MooVx/Domofon/Zdi/IMAG0292.jpg

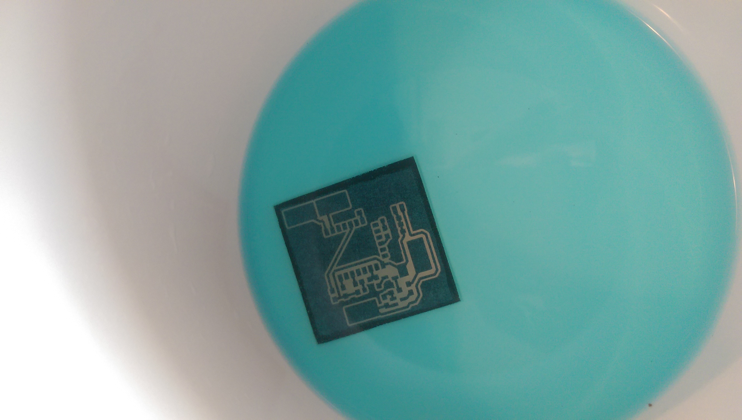
Zdi/IMAG0292.jpg
