MooVx/Domofon/Sprawozdanie.docx

Projekt – Domofon
Paweł Węgrzyn Michał Roman | 23 III 2017 | Czw. 13.30 | G5

1. Cel projektu

Postanowiliśmy wykonać w oparciu o układ ESP8266 sterowanie za pośrednictwem sieci WLAN elektrozamka domofonu. Docelowo po uzyskaniu stabilności działania, układ zamontujemy wewnątrz domofonu, po rozkręceniu aparatu znaleźliśmy wewnątrz łatwo dostępny stabilizator napięcia +12V, postanowiliśmy ze względu na stosunkowo małe zużycie energii wykorzystać to napięcie do zasalania naszego układu. Korzystając z własnego doświadczenia, schematów dostępnych w sieci oraz dokonując pomiarów dowiedzieliśmy się że wyzwolenie zaczepu elektro zamka realizowane jest przez stacje domofonową w mieszkaniu poprzez podciągniecie linii sygnałowej AUDIO do linii POWER. Podczas gdy układ nie jest zasilany stan wyjścia, docelowo zwierającego powyżej wspomniane linie rezystorem 470R, powinien znajdować się w stanie wysokiej impedancji aby nie zakłócać działania innych urządzeń podpiętych do tych linii. Cały układ postanowiliśmy zrealizować w technologii SMD w celu minimalizacji rozmiarów układu.

Podzieliliśmy realizacje projektu na następujące etapy:

a) Zaprojektowanie schematu ideowego układu
b) Zaprojektowanie PCB
c) Wykonanie płytki PCB oraz montaż elementów
d) Testy, poprawa stabilności software’u
2. Schemat ideowy

Sekcja zasilania:

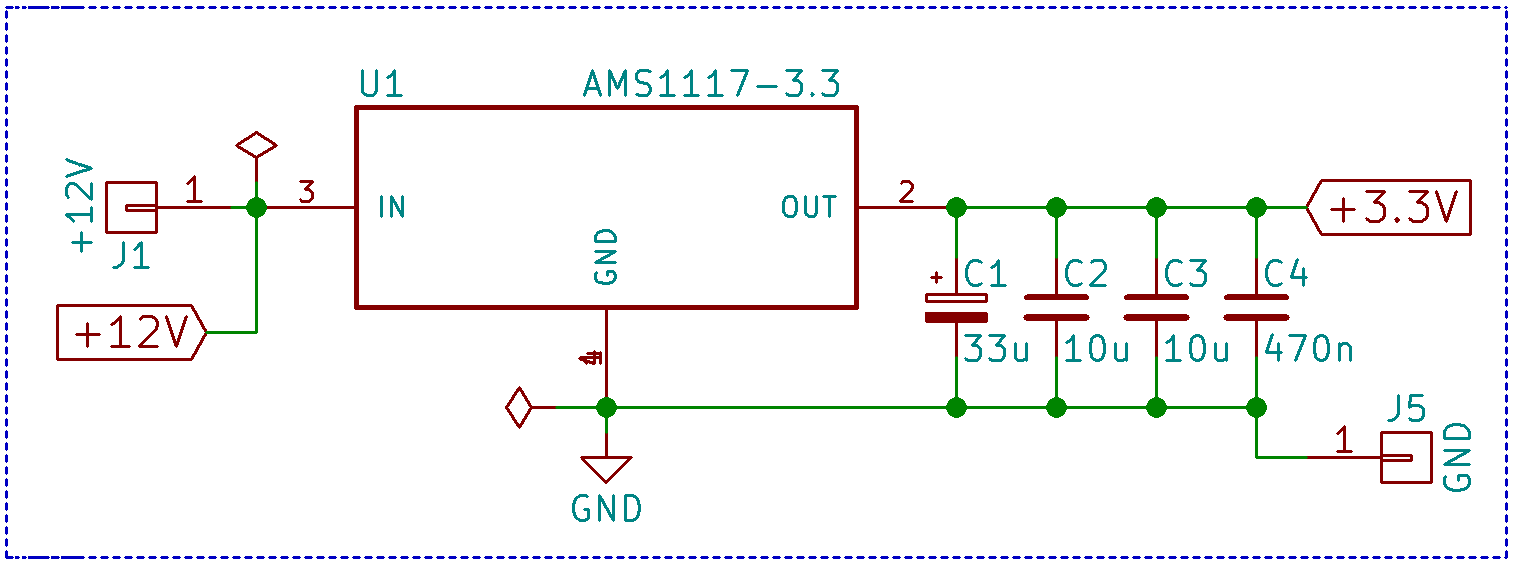
[picture p2: figure]

Zasilanie układu zrealizowane jest na regulatorze napięciowym AMS1117-3.3 który zmniejsza napięcie +12V na napięcie +3.3V. W celu eliminacji szpilek napięciowych zastosowaliśmy filtracje napięcia. Kondensator C1 jest kondensatorem tantalowym, charakteryzują się one małym współczynnikiem ESR, wiec nadaje się do eliminacji szpilek.
Sekcja logiki:

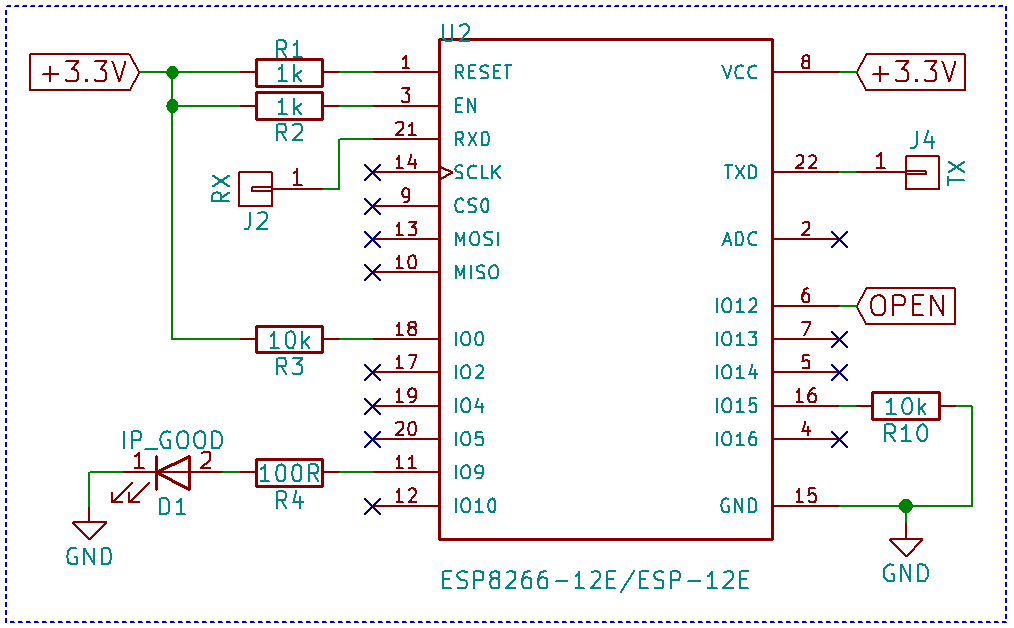
[picture p3: figure]

LED „ IP_GOOD ” podpięty jest do jednego z pinów GPIO, docelowo ma służyć do sygnalizacji prawidłowego otrzymania przydziału adresu IP.

Sekcja sterująca zamkiem:

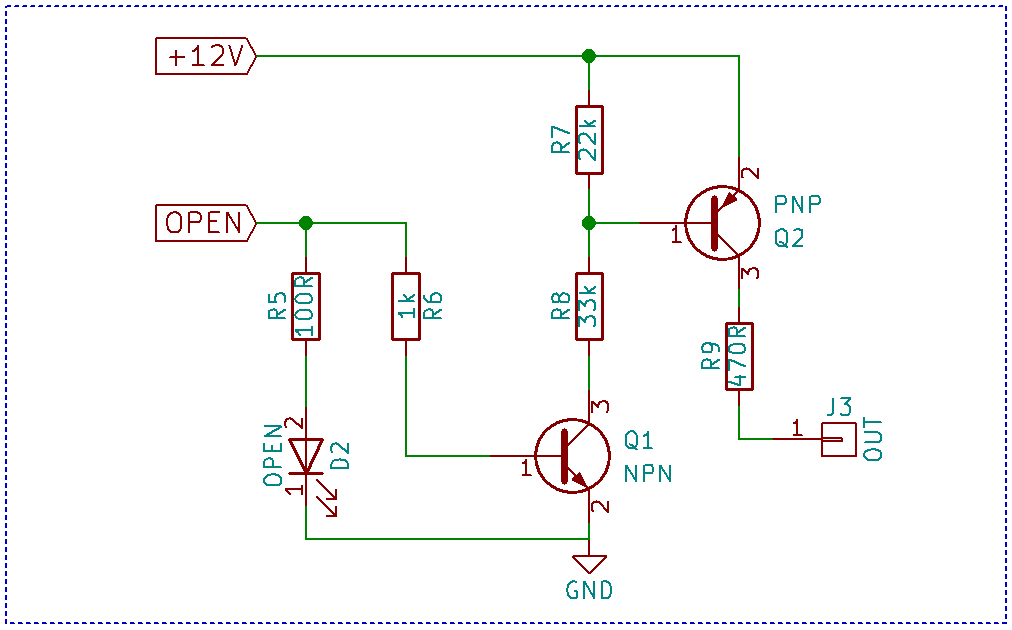
[picture p4: figure]

TODO: policzyć to pasuje xDD

3. Schemat PCB

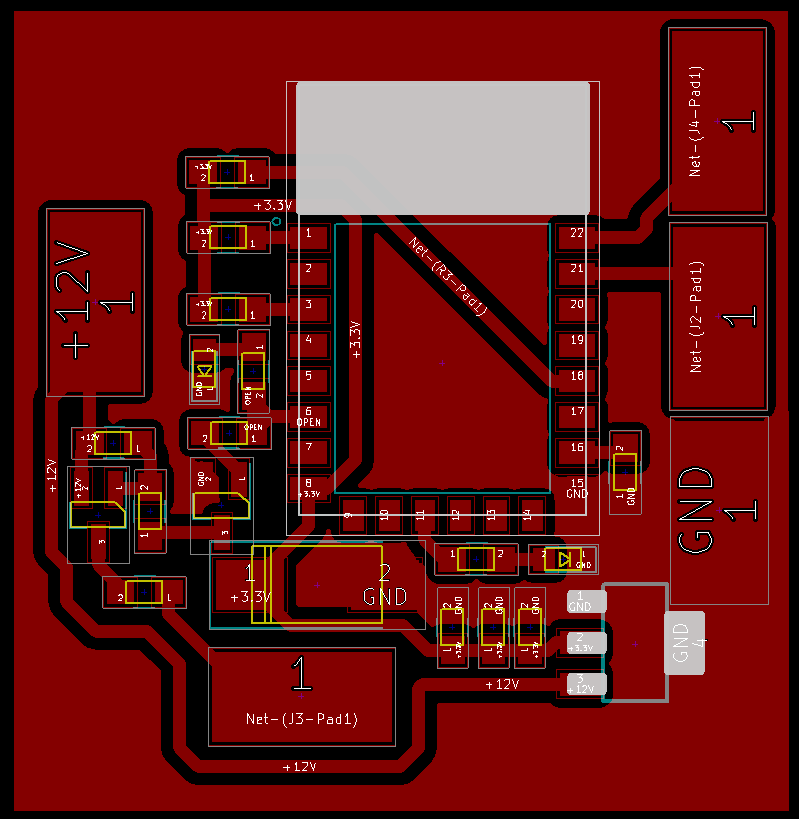
[picture p5: figure]

4. Wykonanie układu

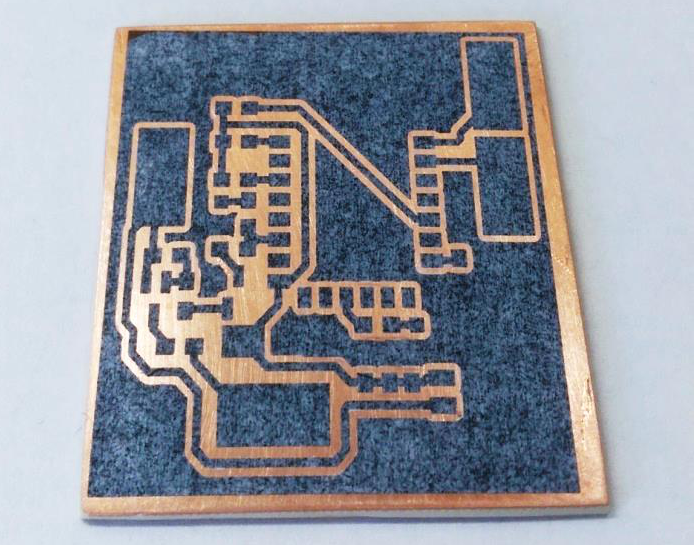
[picture p6: figure]
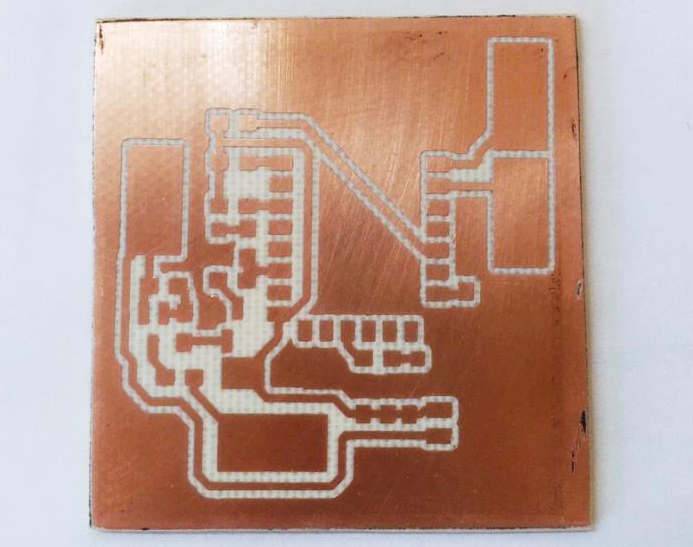
[picture p7: figure]
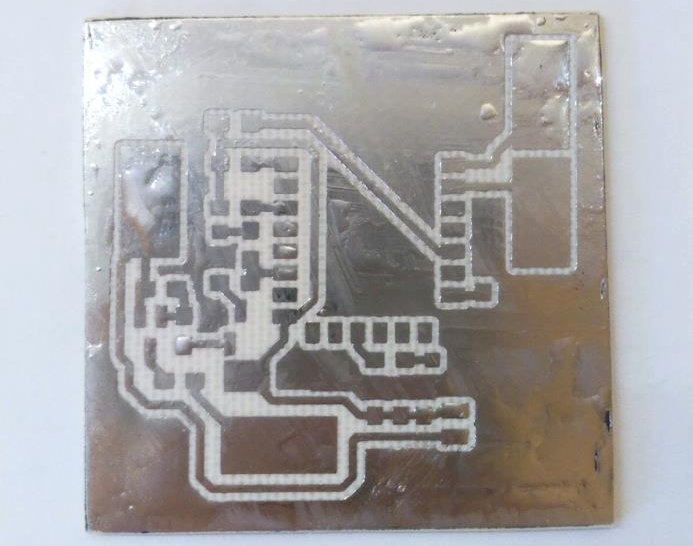
[picture p8: figure]
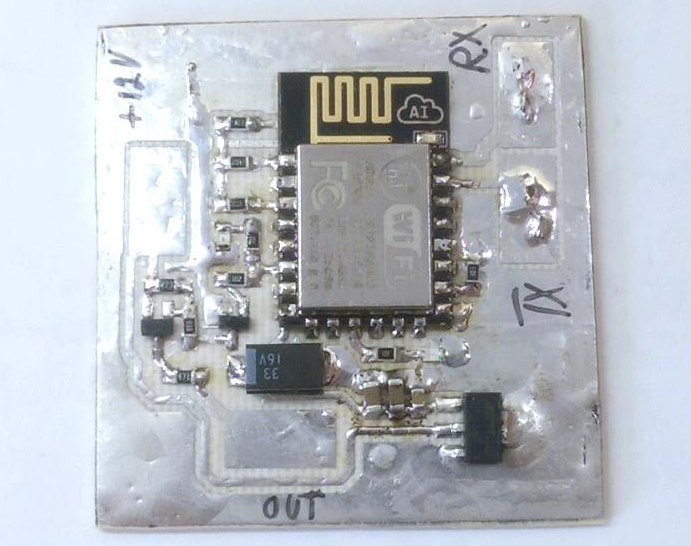
[picture p9: figure]
