MooVx/Domofon/Zdi/IMAG0290.jpg

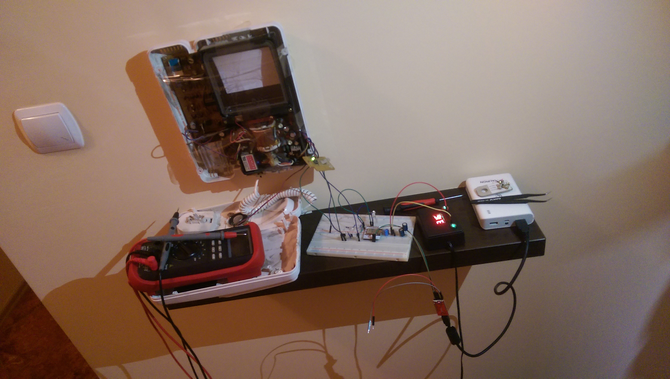
Zdi/IMAG0290.jpg
