MooVx/Domofon/Zdi/IMAG0291.jpg

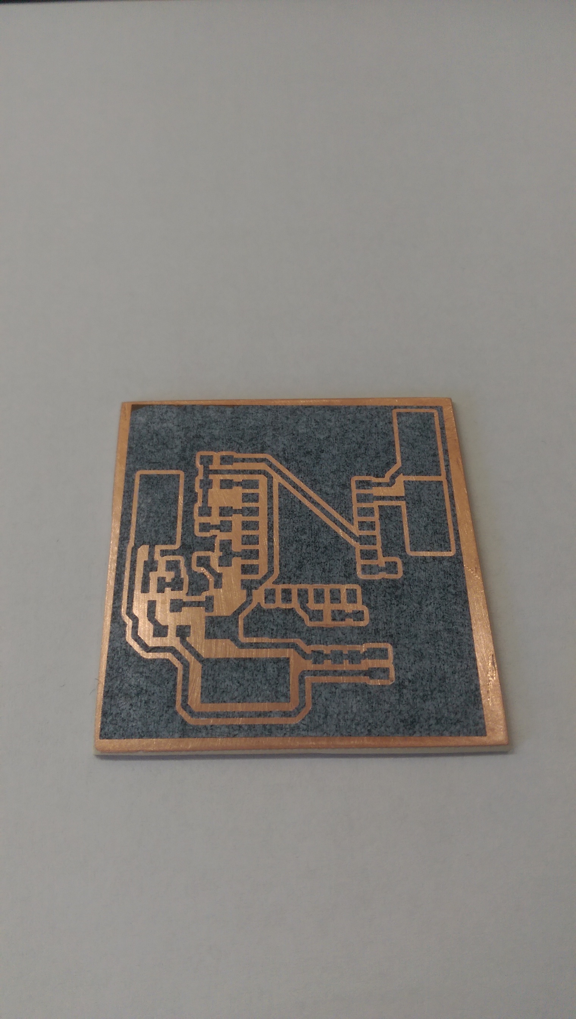
Zdi/IMAG0291.jpg
