MooVx/Domofon/Zdi/IMAG0294.jpg

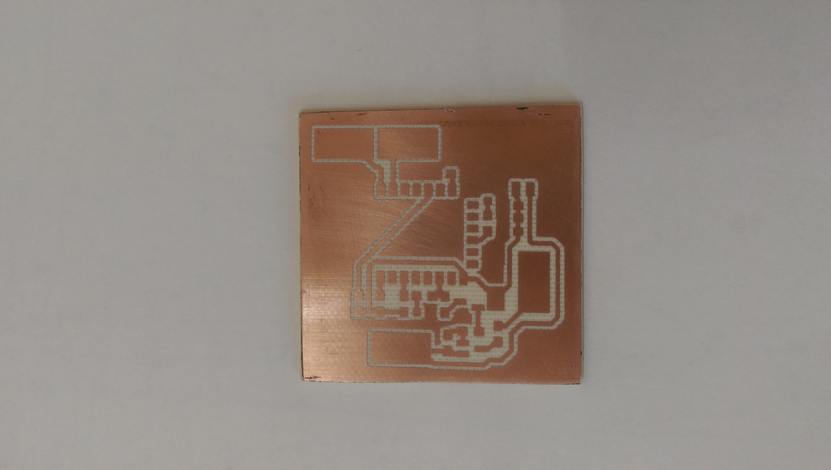
Zdi/IMAG0294.jpg
