MooVx/Domofon/Zdi/IMAG0295.jpg

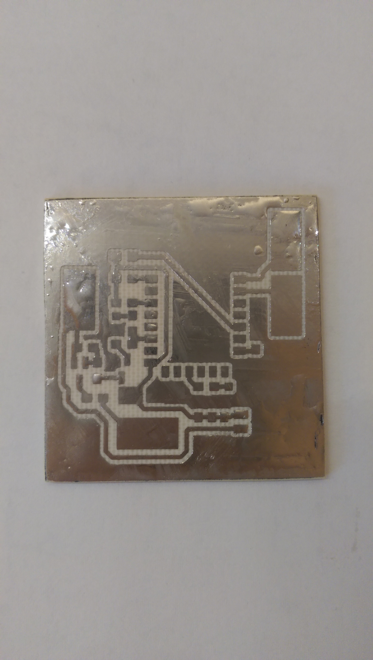
Zdi/IMAG0295.jpg
