MooVx/Domofon/Zdi/IMAG0296.jpg

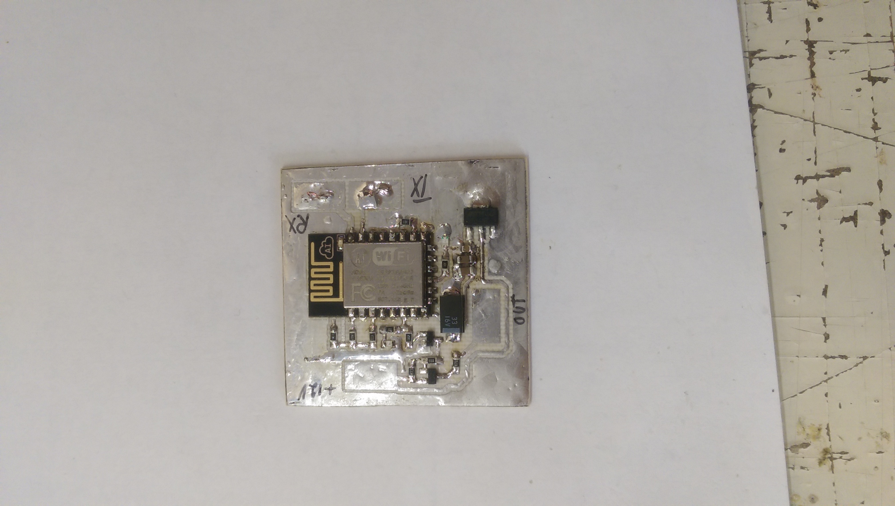
Zdi/IMAG0296.jpg
