MooVx/Domofon/KiCad/PCB.pdf

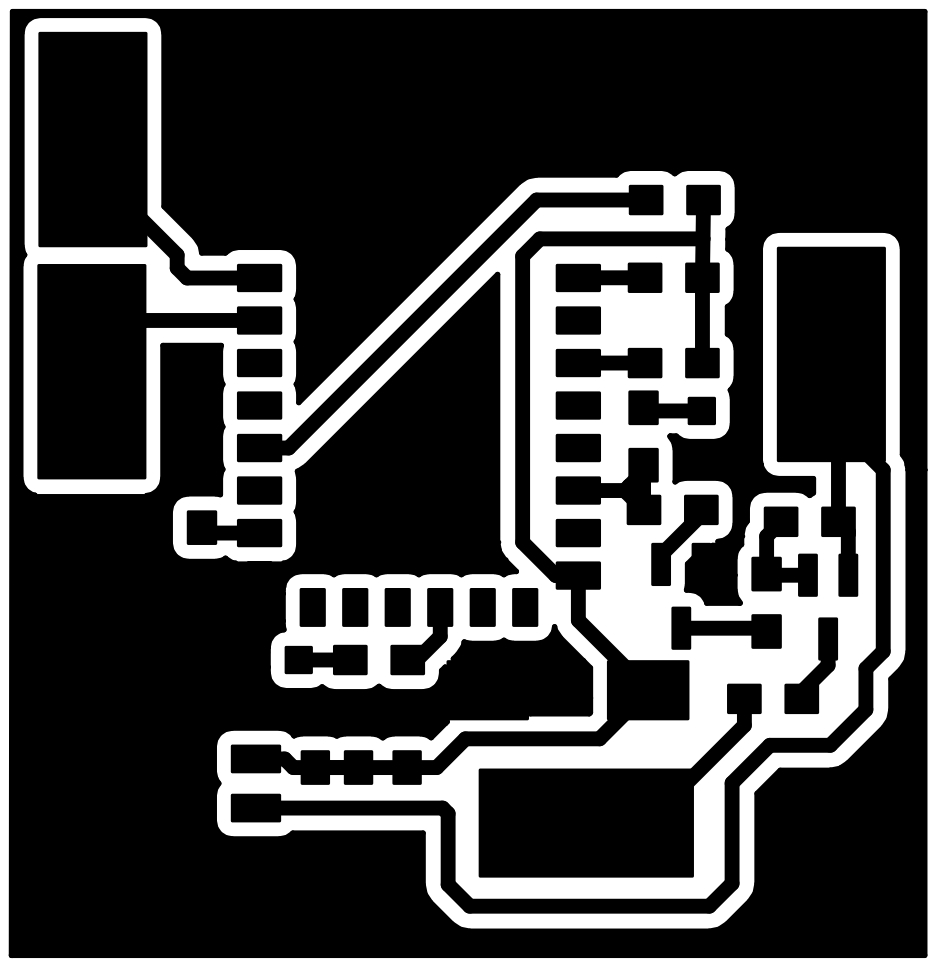
[picture p15: page 1]
