MooVx/Domofon/KiCad/projekt_dom.kicad_pcb

## KiCad design KiCad/projekt_dom.kicad_pcb (2017-05-02)

Schematic: projekt_dom.sch

Parts:
C1: 33u; CP_Tantalum_Case-D_EIA-7343-31_Hand
C2, C3: 10u; C_0805_HandSoldering
C4: 470n; C_0805_HandSoldering
D1: IP_GOOD; LED_0805
D2: OPEN; LED_0805
J1: +12V; SolderWirePad_single_SMD_5x10mm
J2: RX; SolderWirePad_single_SMD_5x10mm
J3: OUT; SolderWirePad_single_SMD_5x10mm
J4: TX; SolderWirePad_single_SMD_5x10mm
J5: GND; SolderWirePad_single_SMD_5x10mm
Q1: NPN; SOT-23_Handsoldering
Q2: PNP; SOT-23_Handsoldering
R1, R2, R6: 1k; R_0805_HandSoldering
R3, R10: 10k; R_0805_HandSoldering
R4, R5: 100R; R_0805_HandSoldering
R7: 22k; R_0805_HandSoldering
R8: 33k; R_0805_HandSoldering
R9: 470R; R_0805_HandSoldering
U1: AMS1117-3.3; SOT-223
U2: ESP8266-12E/ESP-12E; XCVR_ESP8266-12E%2fESP-12E

Connections:
+3.3V: C1.1, C2.1, C3.1, C4.1, R1.2, R2.2, R3.2, U1.2, U2.8 (VCC)
+12V: J1.1, Q2.2, R7.2, U1.3
GND: C1.2, C2.2, C3.2, C4.2, D1.1, D2.1, J5.1, Q1.2, R10.1, U1.1, U1.4, U2.15 (GND)
unnamed: D1.2, R4.2
unnamed: D2.2, R5.1
unnamed: J2.1, U2.21 (RXD)
unnamed: J3.1, R9.1
unnamed: J4.1, U2.22 (TXD)
unnamed: Q1.1, R6.2
unnamed: Q1.3, R8.1
unnamed: Q2.1, R7.1, R8.2
unnamed: Q2.3, R9.2
unnamed: R1.1, U2.1 (RESET)
unnamed: R2.1, U2.3 (EN)
unnamed: R3.1, U2.18 (IO0)
unnamed: R4.1, U2.11 (IO9)
unnamed: R10.2, U2.16 (IO15)
OPEN: R5.2, R6.1, U2.6 (IO12)

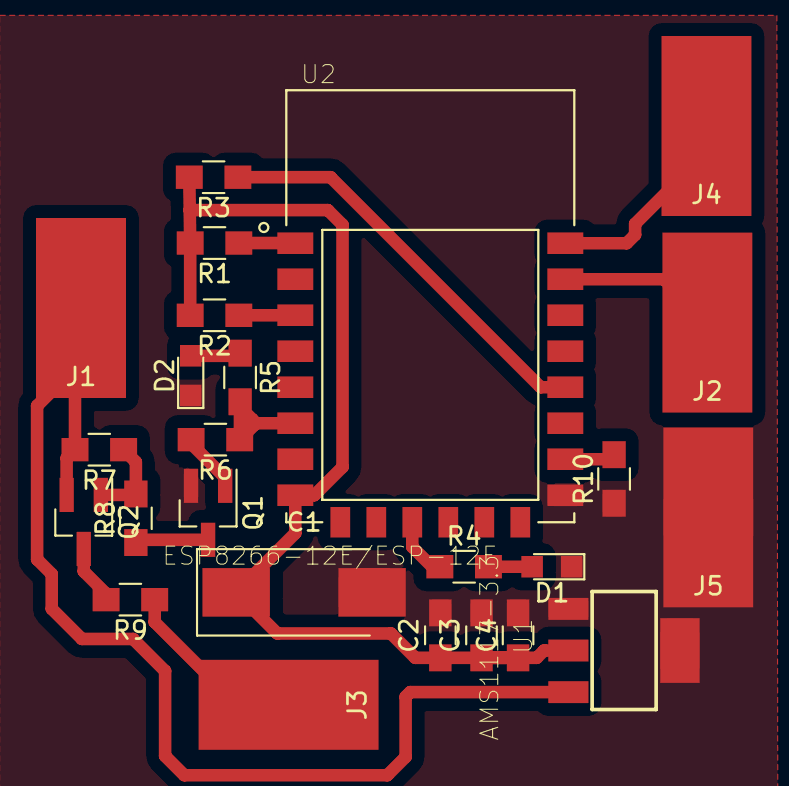
[picture p16: board projekt_dom.kicad_pcb from above]

Board: 2 copper layers, 25 parts (0 on the bottom side), 18 nets.
